Atroyer1/RFIDiceBoard/KiCad/RFIDice_V0_revised/RFIDice_V0_revised.kicad_pcb

## KiCad design KiCad/RFIDice_V0_revised/RFIDice_V0_revised.kicad_pcb (2022-09-20)

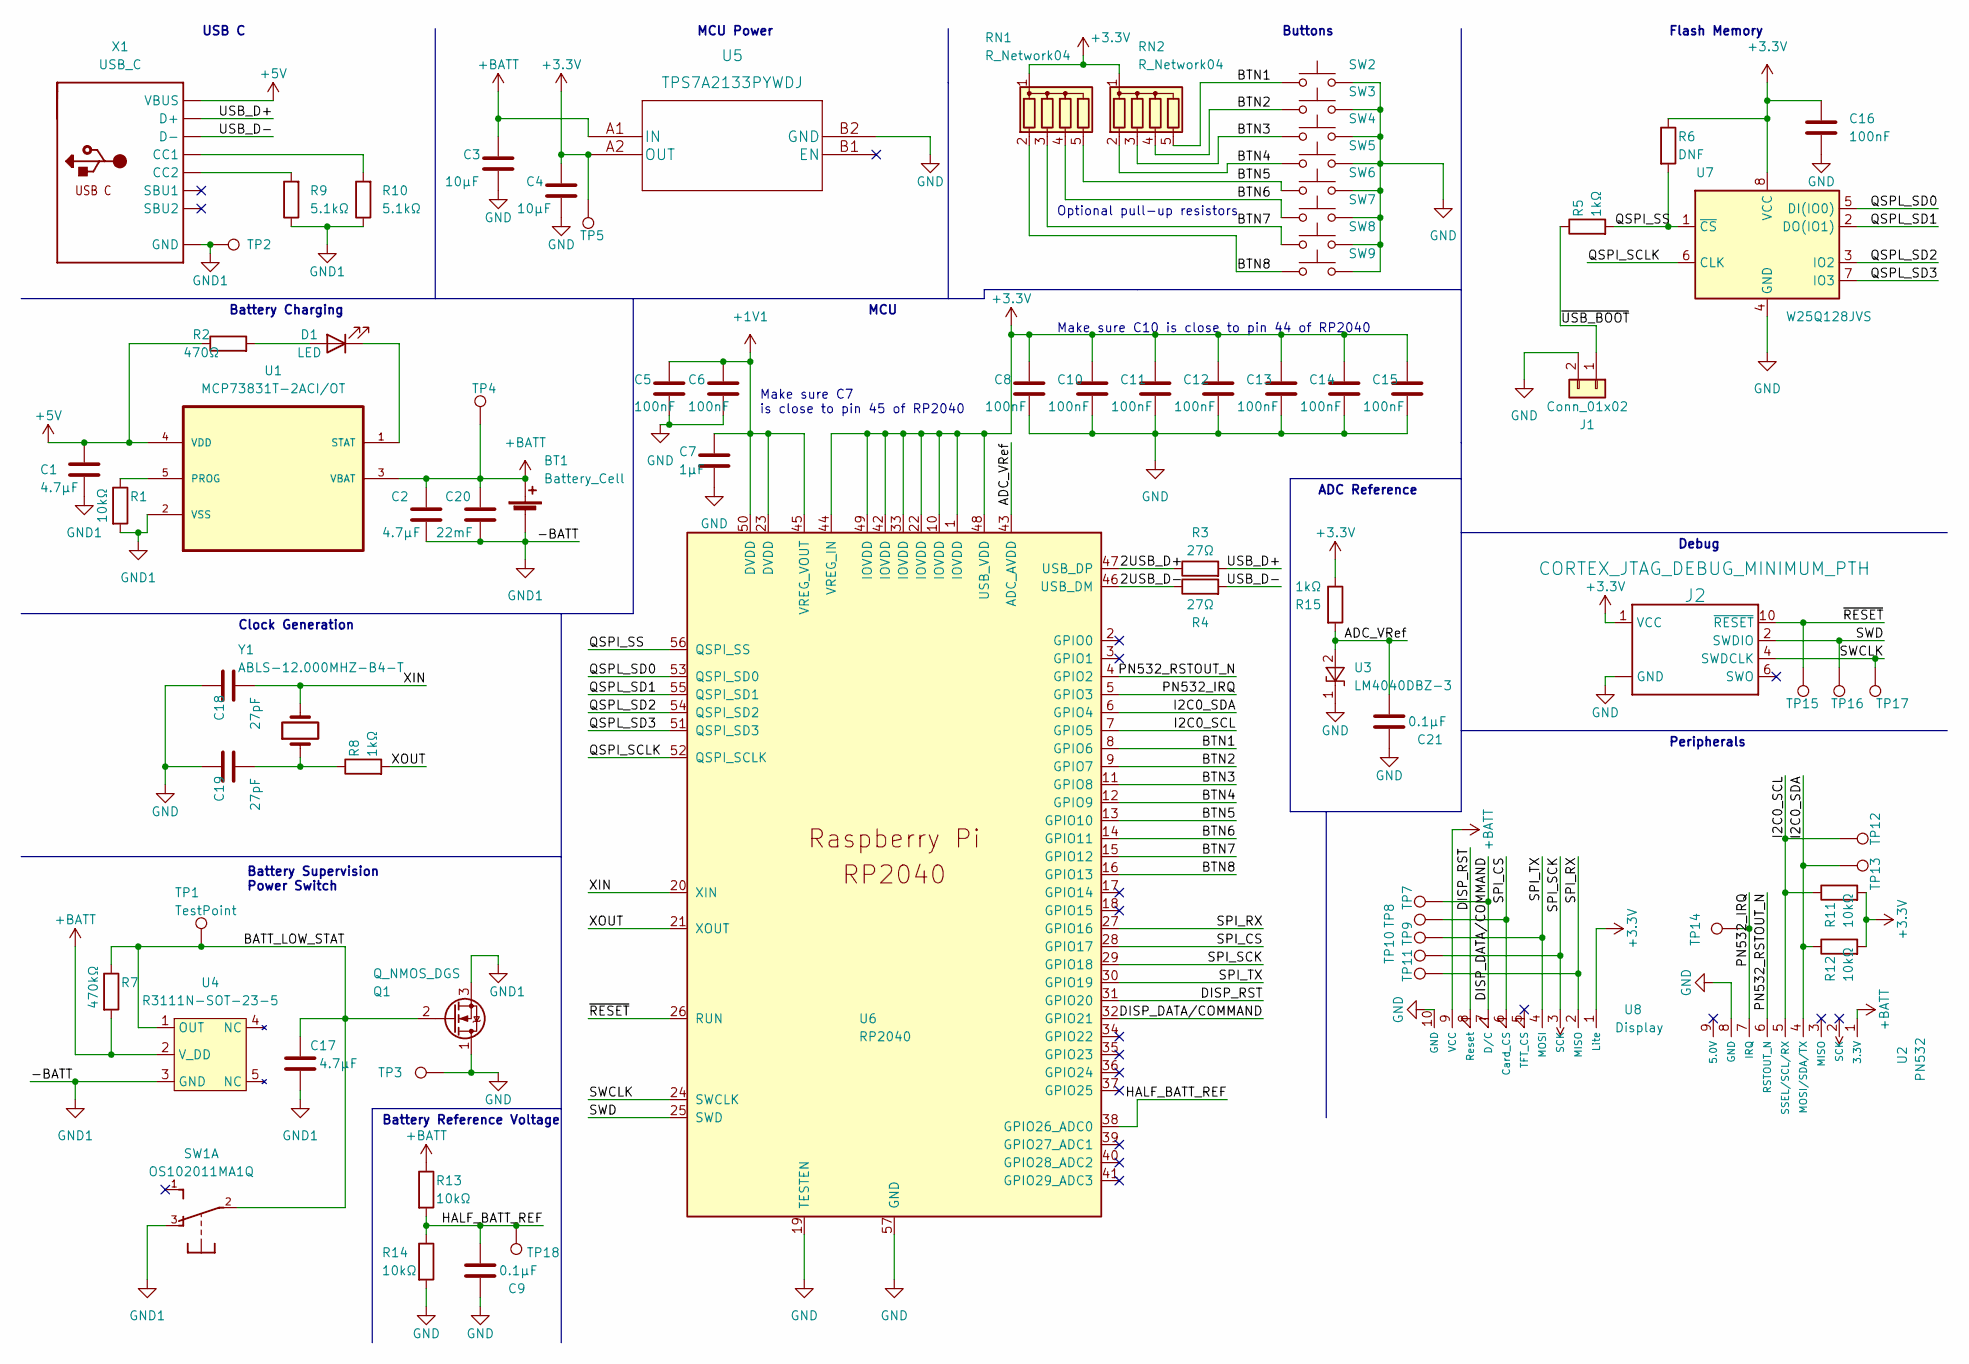
[picture p15: schematic RFIDice_V0_revised.kicad_sch, RFIDiceBoard]

Parts:
BT1: Battery_Cell; AndyBattery
C1, C2, C17: 4.7µF; C_0603_1608Metric_Pad1.08x0.95mm_HandSolder
C3, C4: 10µF; C_0603_1608Metric_Pad1.08x0.95mm_HandSolder
C5, C6, C8, C10, C11, C12, C13, C14, C15, C16: 100nF; C_0603_1608Metric_Pad1.08x0.95mm_HandSolder
C7: 1µF; C_0603_1608Metric_Pad1.08x0.95mm_HandSolder
C9, C21: 0.1µF; C_0603_1608Metric_Pad1.08x0.95mm_HandSolder
C18, C19: 27pF; C_0603_1608Metric_Pad1.08x0.95mm_HandSolder
C20: 22mF; CP_EIA-3528-21_Kemet-B_Pad1.50x2.35mm_HandSolder
D1: LED; LED_0603_1608Metric_Pad1.05x0.95mm_HandSolder
J1: Conn_01x02; PinHeader_1x02_P2.54mm_Vertical
J2: CORTEX_JTAG_DEBUG_MINIMUM_PTH; 2X5-PTH-1.27MM
Q1: Q_NMOS_DGS; SOT-23
R1, R11, R12, R13, R14: 10kΩ; R_0603_1608Metric_Pad0.98x0.95mm_HandSolder
R2: 470Ω; R_0603_1608Metric_Pad0.98x0.95mm_HandSolder
R3, R4: 27Ω; R_0603_1608Metric_Pad0.98x0.95mm_HandSolder
R5, R8, R15: 1kΩ; R_0603_1608Metric_Pad0.98x0.95mm_HandSolder
R6: DNF; R_0603_1608Metric_Pad0.98x0.95mm_HandSolder
R7: 470kΩ; R_0603_1608Metric_Pad0.98x0.95mm_HandSolder
R9, R10: 5.1kΩ; R_0603_1608Metric_Pad0.98x0.95mm_HandSolder
RN1, RN2: R_Network04; R_Array_Convex_4x1206
SW1: OS102011MA1Q
SW2, SW3, SW4, SW5, SW6, SW7, SW8, SW9: SW_Push; EVP-ASDC1A_Tactile_PushButton
TP1, TP2, TP3, TP4, TP5, TP7, TP8, TP9, TP10, TP11, TP12, TP13, TP14, TP15, TP16, TP17, TP18: TestPoint; TestPoint_Keystone_5000-5004_Miniature
U1: MCP73831T-2ACI/OT; SOT-23-5_HandSoldering; MPN MCP73831T-2ACI/OT
U2: PN532; ThroughHolePN532BrkOutBoardMount
U3: LM4040DBZ-3; SOT-23
U4: R3111N-SOT-23-5; SOT-23-5_HandSoldering
U5: TPS7A2133PYWDJ
U6: RP2040; RP2040-QFN-56
U7: W25Q128JVS; SOIC-8_5.23x5.23mm_P1.27mm
U8: Display; ThroughHoldDisplayMount
X1: USB_C; USB_C_CUSB31-CFM2AX-01-X_copy
Y1: ABLS-12.000MHZ-B4-T; Crystal_SMD_HC49-US

Connections:
+1V1: C5.1, C6.1, C7.1, U6.23 (DVDD), U6.45 (VREG_VOUT), U6.50 (DVDD)
+3V3: C4.1, C8.1, C10.1, C11.1, C12.1, C13.1, C14.1, C15.1, C16.1, J2.1 (VCC), R6.1, R11.2, R12.2, R15.1, RN1.1 (common), RN2.1 (common), TP5.1, U5.A2 (OUT), U6.1 (IOVDD), U6.10 (IOVDD), U6.22 (IOVDD), U6.33 (IOVDD), U6.42 (IOVDD), U6.44 (VREG_IN), U6.48 (USB_VDD), U6.49 (IOVDD), U7.8 (VCC), U8.1 (Lite)
+5V: C1.1, R2.1, U1.4 (VDD), X1.A4B9 (VBUS), X1.B4A9 (VBUS)
+BATT: BT1.1 (+), C2.1, C3.1, C20.1, R7.2, R13.1, TP4.1, U1.3 (VBAT), U2.1 (3.3V), U4.2 (V_DD), U5.A1 (IN), U8.9 (VCC)
/2USB_D+: R3.1, U6.47 (USB_DP)
/2USB_D-: R4.1, U6.46 (USB_DM)
/ADC_VRef: C21.1, R15.2, U3.2 (A), U6.43 (ADC_AVDD)
/BATT_LOW_STAT: C17.1, Q1.2 (G), R7.1, SW1.2, TP1.1, U4.1 (OUT)
/BTN1: RN2.5 (R4), SW2.1, U6.8 (GPIO6)
/BTN2: RN2.4 (R3), SW3.1, U6.9 (GPIO7)
/BTN3: RN2.3 (R2), SW4.1, U6.11 (GPIO8)
/BTN4: RN2.2 (R1), SW5.1, U6.12 (GPIO9)
/BTN5: RN1.5 (R4), SW6.1, U6.13 (GPIO10)
/BTN6: RN1.4 (R3), SW7.1, U6.14 (GPIO11)
/BTN7: RN1.3 (R2), SW8.1, U6.15 (GPIO12)
/BTN8: RN1.2 (R1), SW9.1, U6.16 (GPIO13)
/DISP_DATA/COMMAND: TP7.1, U6.32 (GPIO21), U8.7 (D/C)
/DISP_RST: U6.31 (GPIO20), U8.8 (Reset)
/HALF_BATT_REF: C9.1, R13.2, R14.1, TP18.1, U6.38 (GPIO26_ADC0)
/I2C0_SCL: R11.1, TP12.1, U2.5 (SSEL/SCL/RX), U6.7 (GPIO5)
/I2C0_SDA: R12.1, TP13.1, U2.4 (MOSI/SDA/TX), U6.6 (GPIO4)
/PN532_IRQ: TP14.1, U2.7 (IRQ), U6.5 (GPIO3)
/PN532_RSTOUT_N: U2.6 (RSTOUT_N), U6.4 (GPIO2)
/QSPI_SCLK: U6.52 (QSPI_SCLK), U7.6 (CLK)
/QSPI_SS: R5.2, R6.2, U6.56 (QSPI_SS), U7.1 (~CS)
/QSPL_SD0: U6.53 (QSPI_SD0), U7.5 (DI(IO0))
/QSPL_SD1: U6.55 (QSPI_SD1), U7.2 (DO(IO1))
/QSPL_SD2: U6.54 (QSPI_SD2), U7.3 (IO2)
/QSPL_SD3: U6.51 (QSPI_SD3), U7.7 (IO3)
/SPI_CS: TP8.1, U6.28 (GPIO17), U8.6 (Card_CS)
/SPI_RX: TP11.1, U6.27 (GPIO16), U8.2 (MISO)
/SPI_SCK: TP10.1, U6.29 (GPIO18), U8.3 (SCK)
/SPI_TX: TP9.1, U6.30 (GPIO19), U8.4 (MOSI)
/SWCLK: J2.4 (SWDCLK), TP17.1, U6.24 (SWCLK)
/SWD: J2.2 (SWDIO), TP16.1, U6.25 (SWD)
/USB_D+: R3.2, X1.A6 (D+), X1.B6 (D+)
/USB_D-: R4.2, X1.A7 (D-), X1.B7 (D-)
/XIN: C18.2, U6.20 (XIN), Y1.2
/XOUT: R8.2, U6.21 (XOUT)
/~RESET: J2.10 (~RESET), TP15.1, U6.26 (RUN)
/~USB_BOOT: J1.1, R5.1
GND: C3.2, C4.2, C5.2, C6.2, C7.2, C8.2, C9.2, C10.2, C11.2, C12.2, C13.2, C14.2, C15.2, C16.2, C18.1, C19.1, C21.2, J1.2, J2.3 (GND), J2.5 (GND), J2.9 (GND), Q1.1 (D), R14.2, SW2.2, SW3.2, SW4.2, SW5.2, SW6.2, SW7.2, SW8.2, SW9.2, TP3.1, U2.8 (GND), U3.1 (K), U5.B2 (GND), U6.19 (TESTEN), U6.57 (GND), U7.4 (GND), U8.10 (GND)
GND1: BT1.2 (-), C1.2, C2.2, C17.2, C20.2, Q1.3 (S), R1.2, R9.1, R10.1, SW1.3, TP2.1, U1.2 (VSS), U4.3 (GND), X1.A1B12 (GND), X1.B1A12 (GND)
unnamed: C19.2, R8.1, Y1.1
unnamed: D1.1 (K), U1.1 (STAT)
unnamed: D1.2 (A), R2.2
unnamed: R1.1, U1.5 (PROG)
unnamed: R9.2, X1.B5 (CC2)
unnamed: R10.2, X1.A5 (CC1)

Notes on the sheet:
ADC Reference
USB C
Battery Reference Voltage
Debug
Flash Memory
Battery Charging
Battery Supervision Power Switch
MCU
Make sure C7 is close to pin 45 of RP2040
Clock Generation
Make sure C10 is close to pin 44 of RP2040
MCU Power
Optional pull-up resistors
Peripherals
Buttons

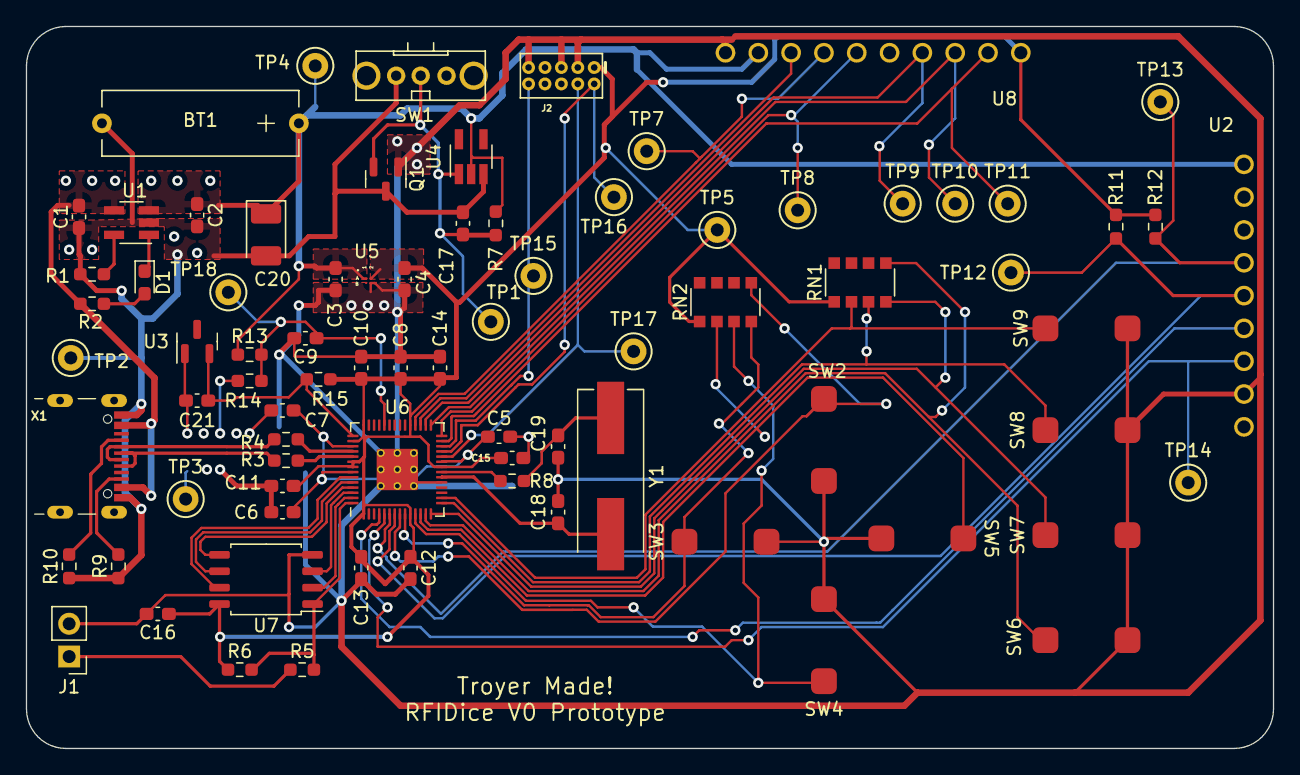
[picture p16: board RFIDice_V0_revised.kicad_pcb from above]

Board: 2 copper layers, 96.5 x 55.9 mm, 79 parts (0 on the bottom side), 49 nets.
