Atroyer1/RFIDiceBoard/(commit log)

2022-09-20 Added documentation and KiCad
    [RFIDice_V0_revised-B_Cu.gbr, RFIDice_V0_revised-B_Mask.gbr, RFIDice_V0_revised-B_Paste.gbr, RFIDice_V0_revised-B_Silkscreen.gbr, RFIDice_V0_revised-Edge_Cuts.gbr, RFIDice_V0_revised-F_Cu.gbr, RFIDice_V0_revised-F_Mask.gbr, RFIDice_V0_revised-F_Paste.gbr]
2022-10-19 troyermade folder contains a clean start with a display init for the final software prototype
2022-10-27 bus_scan added to prototype
2022-11-07 Buttons kinda work
2022-11-08 getFirmwareVersion prototype working
2022-11-17 Added delays and hardware maybe issue went away
    [main.c]
2022-11-30 adc test ready
2022-12-01 adc working. All things working. Time for OSing
2022-12-08 Trying and failing to get systickdelay moving
    [main.c, systickdelay.c, tftdisplay.c, tftdisplay.h]
2022-12-17 reorganized and got a timer working for adc irq
2022-12-19 Battery display prototype working
2022-12-19 Hysteresis added to battery display
2022-12-23 Buttons debounced by automagic hysteresis on the RP2040
2022-12-31 Buttons didn't work as planned. Got a cooperative loop going though
    [adc.c, adc.h, buttons.c, buttons.h, main.c, pn532.c, pn532.h]
2023-01-03 Timer delay working, button 1 working
2023-03-03 Added buttons to the screen
